CreativeRobotics/EnactiveTorchRT2/README.md

# EnactiveTorchRT2
Enactive Torch RT version 2

Hardware and software files for the Enactive Torch Research Tool version 2.
Software uses the Arduino IDE and the Creative Robotics Arduino core.
Schematics and PCB are designed with KiCad.
