CreativeRobotics/EnactiveTorchRT2/Firmware/DCU/ETRT-DCU1/RTCZero-SAMD51_E54/README.adoc

= RTC Library for Arduino =

The RTC library enables an Arduino Zero or MKR1000 board to take control of the internal RTC.

Now supporting SAMD51 & E5x processors

For more information about this library please visit us at
http://arduino.cc/en/Reference/RTC

== License ==

Copyright (c) Arduino LLC. All right reserved.

This library is free software; you can redistribute it and/or
modify it under the terms of the GNU Lesser General Public
License as published by the Free Software Foundation; either
version 2.1 of the License, or (at your option) any later version.

This library is distributed in the hope that it will be useful,
but WITHOUT ANY WARRANTY; without even the implied warranty of
MERCHANTABILITY or FITNESS FOR A PARTICULAR PURPOSE. See the GNU
Lesser General Public License for more details.

You should have received a copy of the GNU Lesser General Public
License along with this library; if not, write to the Free Software
Foundation, Inc., 51 Franklin St, Fifth Floor, Boston, MA 02110-1301 USA
