CreativeRobotics/EnactiveTorchRT2/Hardware/DCU/DCUSchematic.pdf

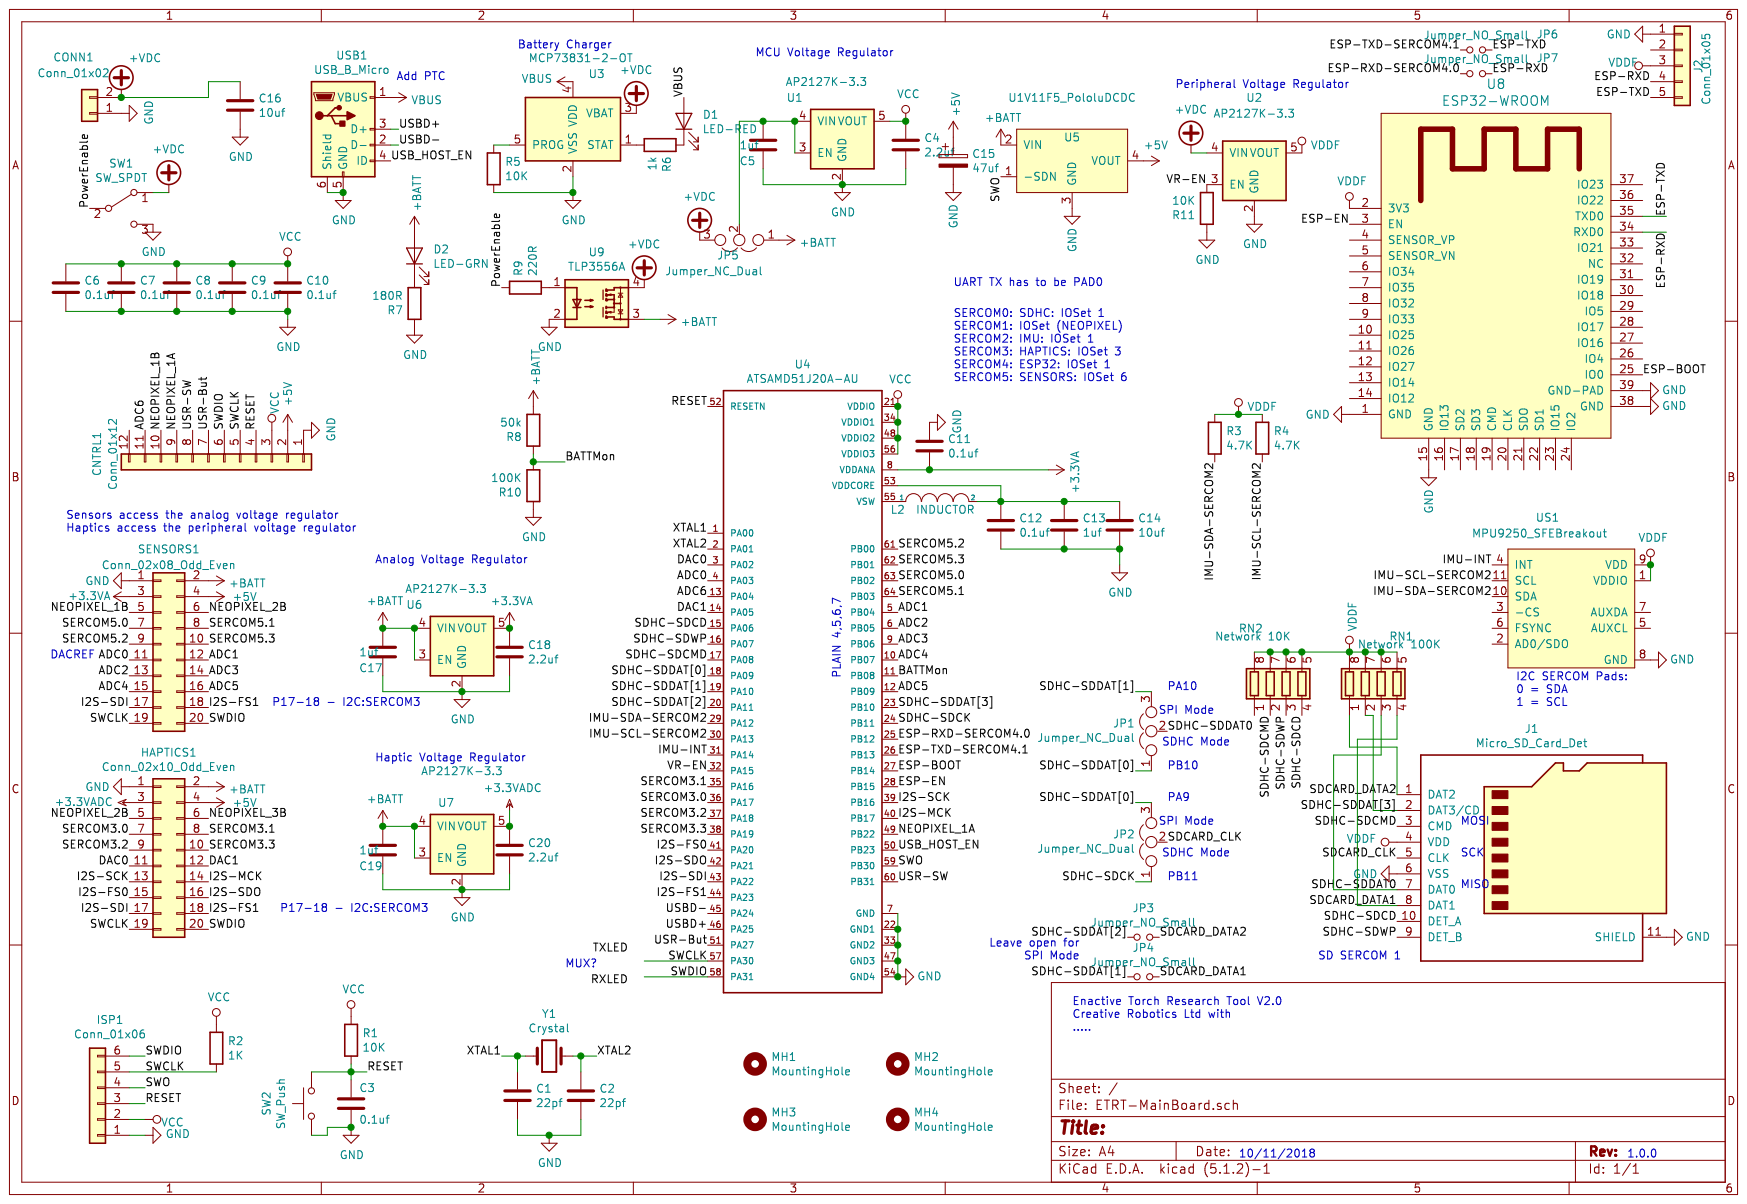
[picture p13: page 1]
