CreativeRobotics/EnactiveTorchRT2/Hardware/Haptic1/Haptic1Schematic.pdf

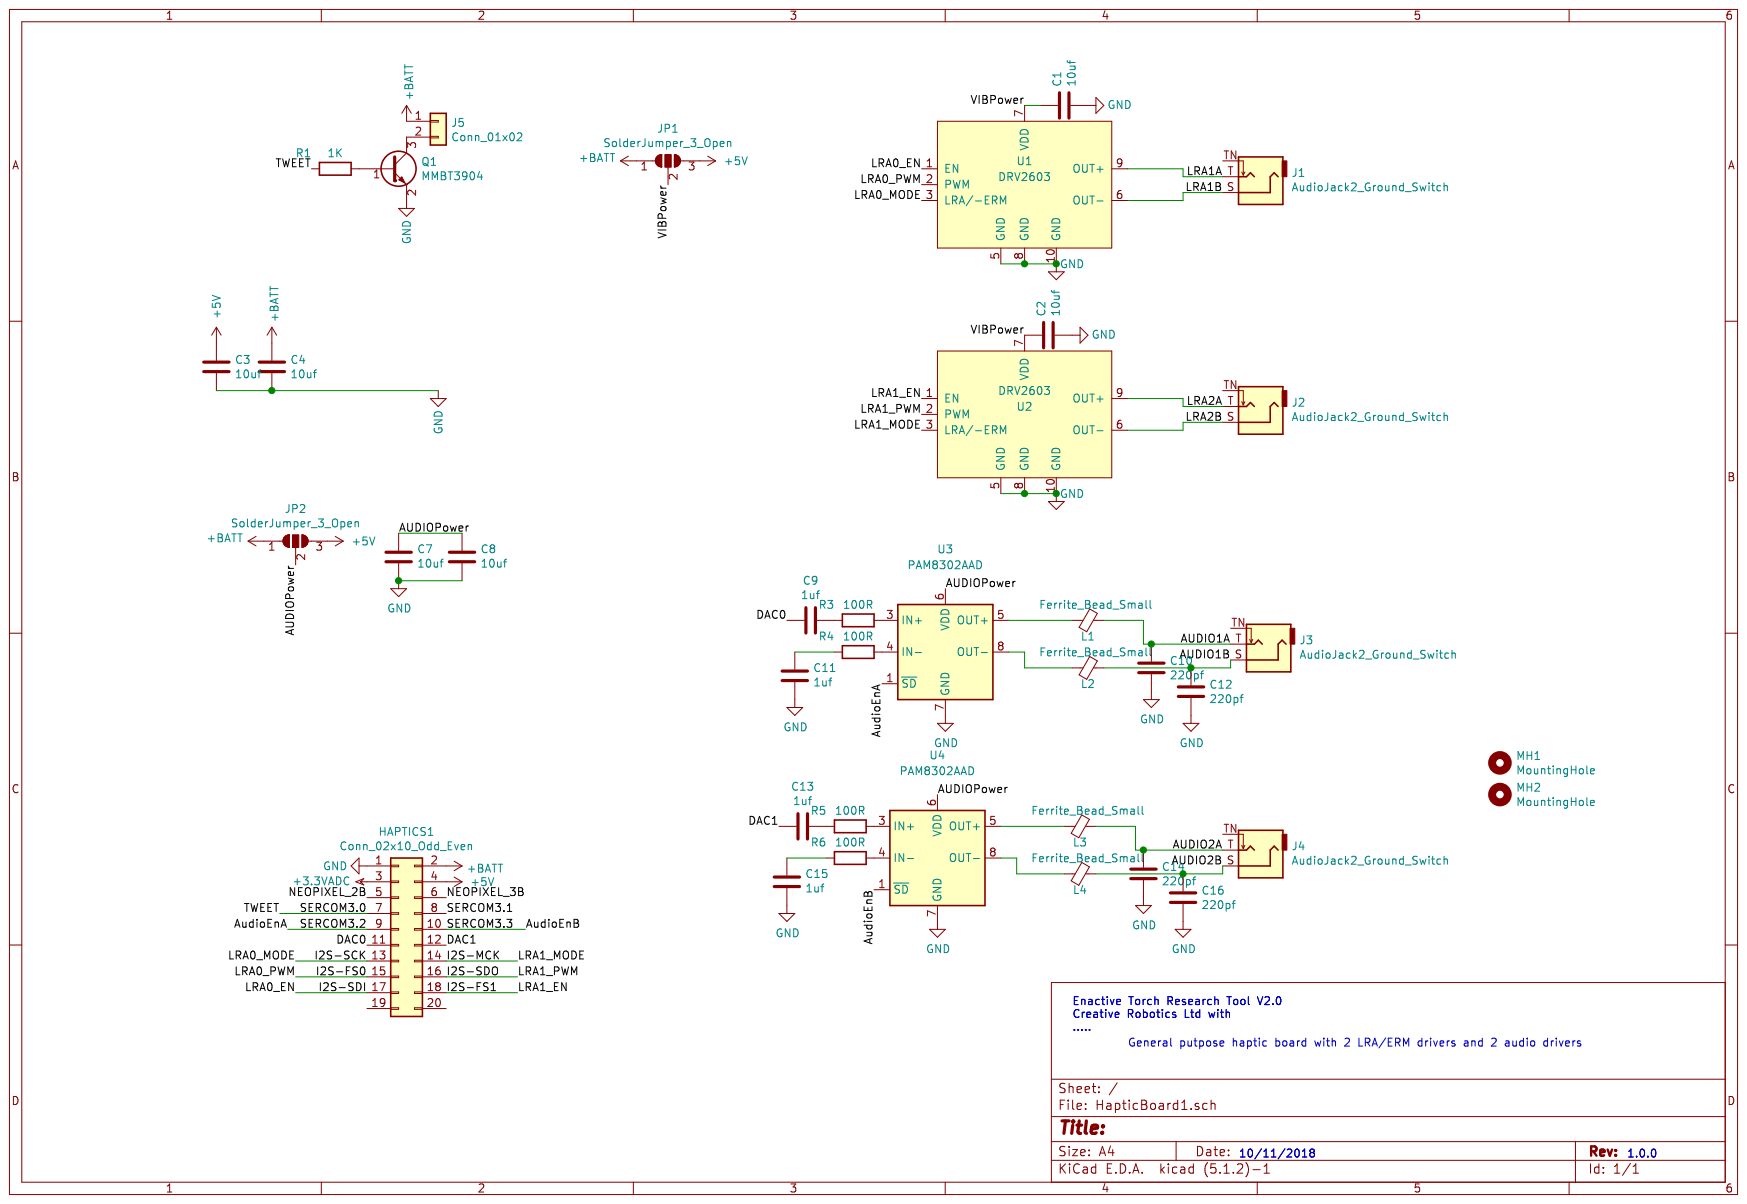
[picture p14: page 1]
