CreativeRobotics/EnactiveTorchRT2/Hardware/Sensor1/SensorBoard1Schematic.pdf

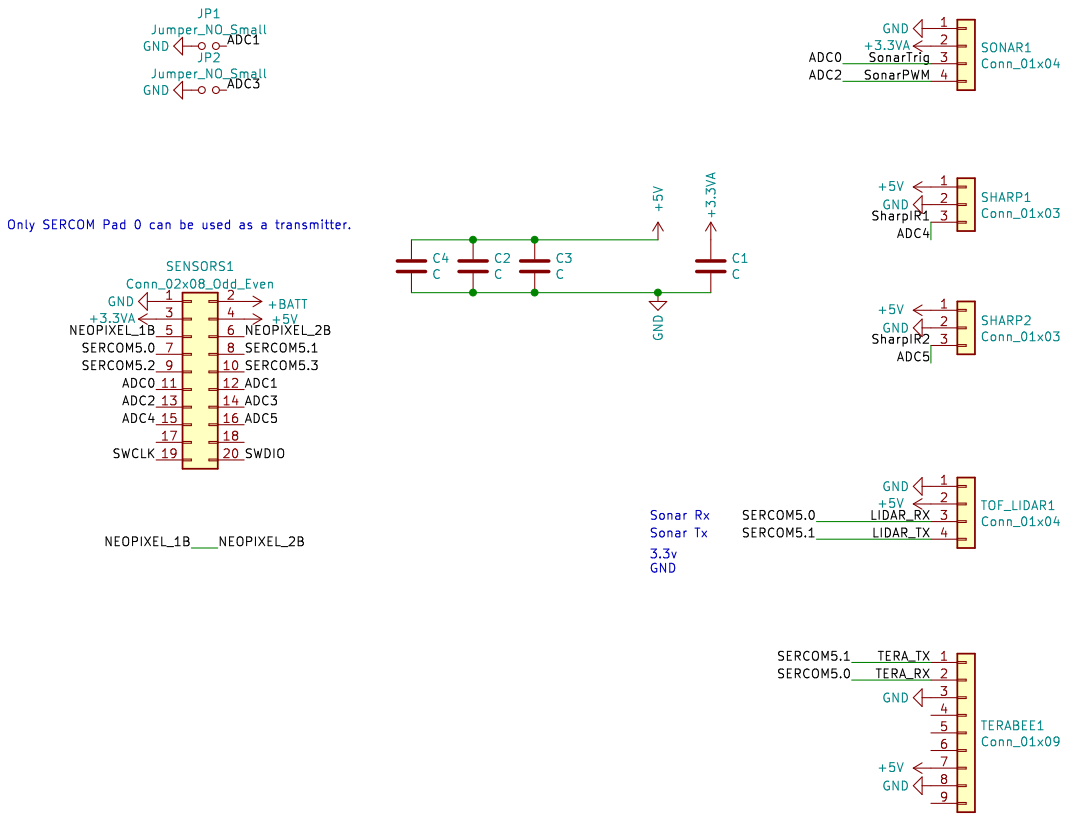
[picture p15: page 1]
