CreativeRobotics/EnactiveTorchRT2/Firmware/ESP32/ETRT_WiFi2/startup.ino

/*void waitForStart(){
  //wait here until the ETRT sends a configuration command
  WiFi.begin(myssid, password);
  //connectToWiFi()
  server.begin();

  SerialBT.begin("ETRT_V2");
}*/


void setPortMode(serialBuffer_t &sBuff, serialPortMode_t pMode){
  sBuff.mode = pMode;
}

void initSerialPort(){
  Serial.begin(115200);
  resetBuffer(sBuffer);
  sBuffer.bufferString.reserve(SBUFFER);
  sBuffer.port = &Serial;
  //Setup pass through ports
  sBuffer.altPort = &Serial;
  setPortMode(sBuffer, COMMAND_MODE); 
  //DEBUG.println("Serial initialised");
}
