CreativeRobotics/EnactiveTorchRT2/Firmware/DCU/ETRT-DCU1/src/Drivers/SimpleWaves.h

//Simple waveform Library
#ifndef SIMPLEWAVES_H
#define SIMPLEWAVES_H

#include "Arduino.h"

#define SIN_TABLE_LENGTH 1024
#define SIN_TABLE_ZERO 0x800

	typedef enum waveType_t{
		SINE = 0,
		SQUARE,
		TRIANGLE,
		SAWF,
		SAWB,
		ONESHOT,
    HALFSHOT
	} waveType_t;
	
class SimpleWaves {
public:
	
	void begin(waveType_t wave = SINE);
	void update();
	void setType(waveType_t wave);
	void set(float frequency, float amplitude);
	void set(float frequency, float amplitude, waveType_t wave);
  void pause() {paused = true;}
  void resume() {paused = false;}
	float output() {return waveOut*amp;}
  uint16_t  getScaledAudio(uint16_t maxVal);
	void setFrequency(float fHertz) {freq = fHertz;}
	void setAmplitude(float amplitude) {amp = amplitude;}
	float getDeltaT() {return deltaT;}
	
	unsigned long debugGet0(){return oneShotChange;}
  unsigned long debugGet1(){return oneShotEnd;}
  unsigned long debugGet2(){return 0;}
  float debugGetF0(){return freq;}
private:
void updateTimeDelta();
	waveType_t waveType;
	void updateSin();
	void updateSquare();
	void updateTriangle();
	void updateSawF();
	void updateSawB();
  void updateOneshot();
  void updateHalfshot();
	float getSin(uint16_t index);
	void updateSquarePeriod();
	unsigned long squarePeriod;
	float waveOut = 0.0;
	
	unsigned long lastUpdate = 0;
	float deltaT = 0.0;
	
	float sinStep = 0.0;
	float triangleDirection = 1.0;
	unsigned long nextSquareUpdate = 0;
 unsigned long oneShotEnd = 0;
 unsigned long oneShotChange = 0;
 uint8_t oneShotState = 0;
	float freq = 100.0;
	float amp = 1.0;
	float squareState = 1.0;
	uint16_t sinIndex = 0;
	bool paused = false;
  
	uint16_t sinTable[SIN_TABLE_LENGTH] = 
		{ 0x800,0x80c,0x819,0x825,0x832,0x83e,0x84b,0x858,
			0x864,0x871,0x87d,0x88a,0x896,0x8a3,0x8af,0x8bc,
			0x8c8,0x8d5,0x8e1,0x8ee,0x8fa,0x907,0x913,0x920,
			0x92c,0x939,0x945,0x951,0x95e,0x96a,0x977,0x983,
			0x98f,0x99c,0x9a8,0x9b4,0x9c1,0x9cd,0x9d9,0x9e5,
			0x9f1,0x9fe,0xa0a,0xa16,0xa22,0xa2e,0xa3a,0xa46,
			0xa52,0xa5e,0xa6a,0xa76,0xa82,0xa8e,0xa9a,0xaa6,
			0xab2,0xabe,0xaca,0xad5,0xae1,0xaed,0xaf8,0xb04,
			0xb10,0xb1b,0xb27,0xb32,0xb3e,0xb49,0xb55,0xb60,
			0xb6c,0xb77,0xb82,0xb8e,0xb99,0xba4,0xbaf,0xbba,
			0xbc6,0xbd1,0xbdc,0xbe7,0xbf2,0xbfd,0xc07,0xc12,
			0xc1d,0xc28,0xc33,0xc3d,0xc48,0xc52,0xc5d,0xc68,
			0xc72,0xc7c,0xc87,0xc91,0xc9b,0xca6,0xcb0,0xcba,
			0xcc4,0xcce,0xcd8,0xce2,0xcec,0xcf6,0xd00,0xd0a,
			0xd13,0xd1d,0xd27,0xd30,0xd3a,0xd43,0xd4d,0xd56,
			0xd60,0xd69,0xd72,0xd7b,0xd84,0xd8e,0xd97,0xd9f,
			0xda8,0xdb1,0xdba,0xdc3,0xdcc,0xdd4,0xddd,0xde5,
			0xdee,0xdf6,0xdfe,0xe07,0xe0f,0xe17,0xe1f,0xe27,
			0xe2f,0xe37,0xe3f,0xe47,0xe4f,0xe56,0xe5e,0xe66,
			0xe6d,0xe75,0xe7c,0xe83,0xe8b,0xe92,0xe99,0xea0,
			0xea7,0xeae,0xeb5,0xebc,0xec2,0xec9,0xed0,0xed6,
			0xedd,0xee3,0xeea,0xef0,0xef6,0xefc,0xf02,0xf08,
			0xf0e,0xf14,0xf1a,0xf20,0xf25,0xf2b,0xf31,0xf36,
			0xf3b,0xf41,0xf46,0xf4b,0xf50,0xf55,0xf5a,0xf5f,
			0xf64,0xf69,0xf6d,0xf72,0xf77,0xf7b,0xf80,0xf84,
			0xf88,0xf8c,0xf90,0xf94,0xf98,0xf9c,0xfa0,0xfa4,
			0xfa8,0xfab,0xfaf,0xfb2,0xfb6,0xfb9,0xfbc,0xfbf,
			0xfc2,0xfc5,0xfc8,0xfcb,0xfce,0xfd1,0xfd3,0xfd6,
			0xfd8,0xfdb,0xfdd,0xfdf,0xfe1,0xfe3,0xfe5,0xfe7,
			0xfe9,0xfeb,0xfed,0xfee,0xff0,0xff1,0xff3,0xff4,
			0xff5,0xff7,0xff8,0xff9,0xffa,0xffb,0xffb,0xffc,
			0xffd,0xffd,0xffe,0xffe,0xffe,0xfff,0xfff,0xfff,
			0xfff,0xfff,0xfff,0xfff,0xffe,0xffe,0xffd,0xffd,
			0xffc,0xffc,0xffb,0xffa,0xff9,0xff8,0xff7,0xff6,
			0xff5,0xff4,0xff2,0xff1,0xfef,0xfee,0xfec,0xfea,
			0xfe8,0xfe6,0xfe4,0xfe2,0xfe0,0xfde,0xfdc,0xfd9,
			0xfd7,0xfd4,0xfd2,0xfcf,0xfcc,0xfca,0xfc7,0xfc4,
			0xfc1,0xfbe,0xfba,0xfb7,0xfb4,0xfb0,0xfad,0xfa9,
			0xfa6,0xfa2,0xf9e,0xf9a,0xf96,0xf92,0xf8e,0xf8a,
			0xf86,0xf82,0xf7d,0xf79,0xf74,0xf70,0xf6b,0xf66,
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
};
#endif //SIMPLEWAVES_H
