CreativeRobotics/EnactiveTorchRT2/(commit log)

2019-05-10 Add sparkfun IMU lib
2019-08-05 Update documentation
    Updated user guide, added battery statement.
2019-08-08 Software update
    Added button toggle behaviour. Fixed some issues with Sonar - but Sonar interrupts are still misbehaving...
    [CommandHandlers.ino, DCU_States.ino, ETRT-DCU.h, ETRT-DCU1.ino, GPHaptics.cpp, GPHaptics.h, GPSensor.cpp, GPSensor.h]
